nikhilrenny/555-pwm-bandpass-signal-generator/images/hardware/scope_full_chain/scope_05.jpg

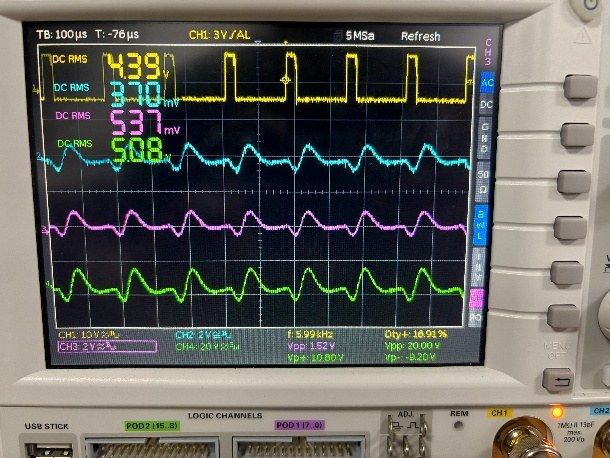
images/hardware/scope_full_chain/scope_05.jpg
