nikhilrenny/555-pwm-bandpass-signal-generator/images/hardware/scope_pwm_filter/scope_05.jpg

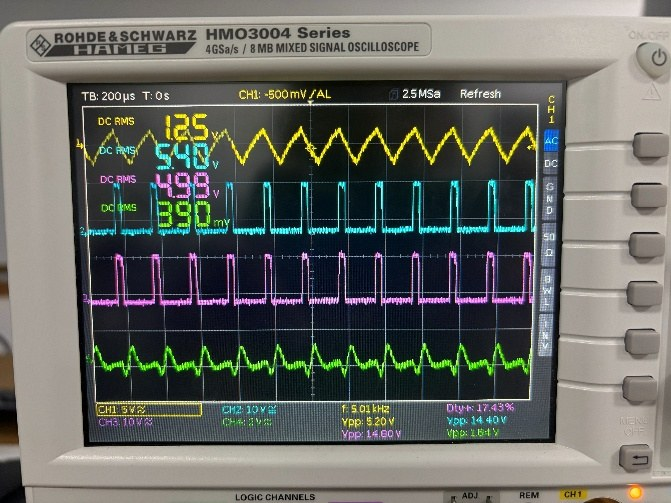
images/hardware/scope_pwm_filter/scope_05.jpg
