nikhilrenny/555-pwm-bandpass-signal-generator/images/hardware/scope_pwm_filter/scope_13.jpg

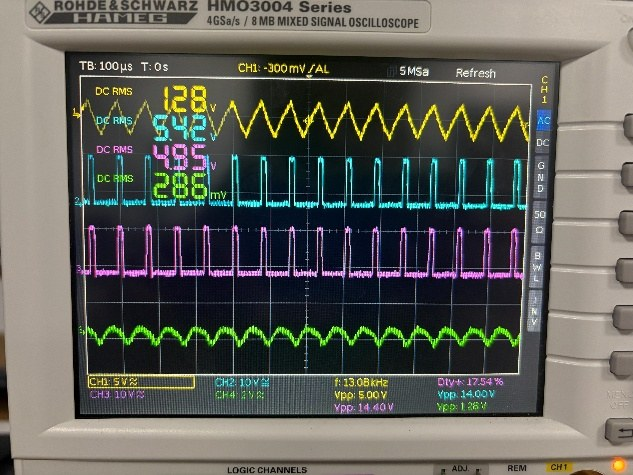
images/hardware/scope_pwm_filter/scope_13.jpg
