nikhilrenny/555-pwm-bandpass-signal-generator/images/schematics/block_diagram.jpg

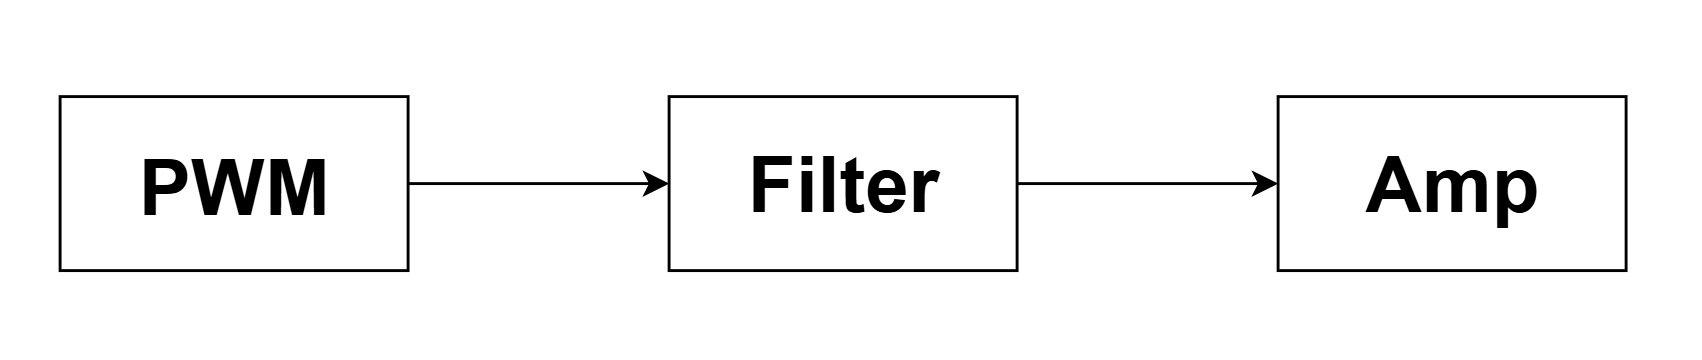
images/schematics/block_diagram.jpg
