nikhilrenny/555-pwm-bandpass-signal-generator/images/schematics/mfb_bandpass_filter.jpg

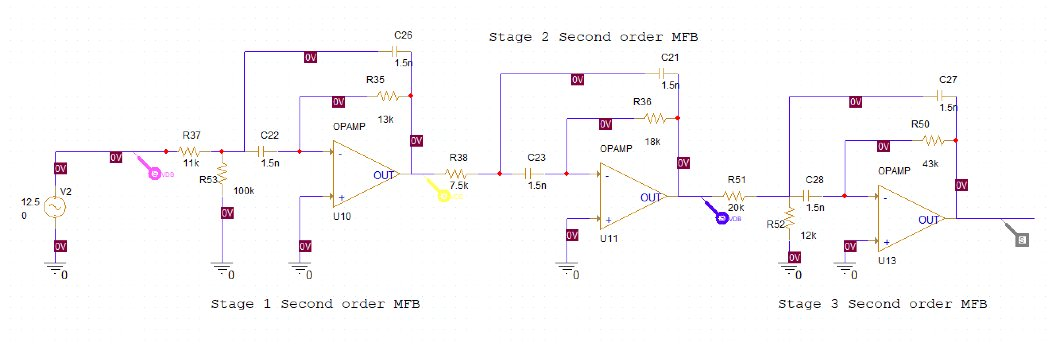
images/schematics/mfb_bandpass_filter.jpg
