nikhilrenny/555-pwm-bandpass-signal-generator/images/schematics/output_amplifier.jpg

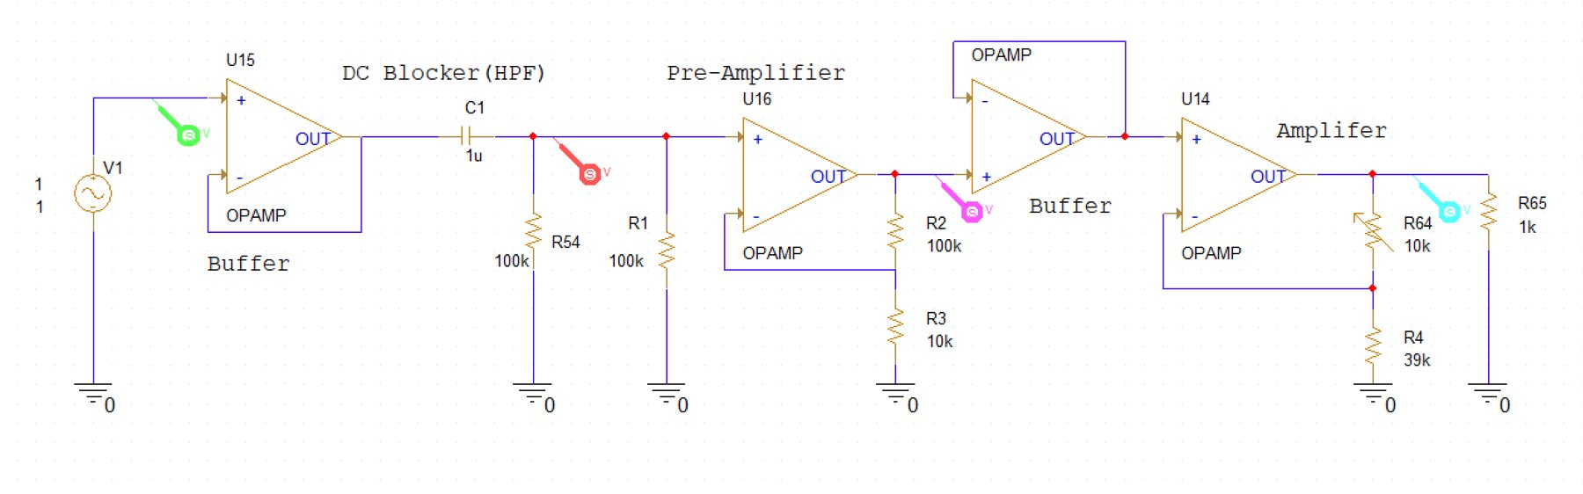
images/schematics/output_amplifier.jpg
