nikhilrenny/555-pwm-bandpass-signal-generator/images/schematics/pwm_generator.jpg

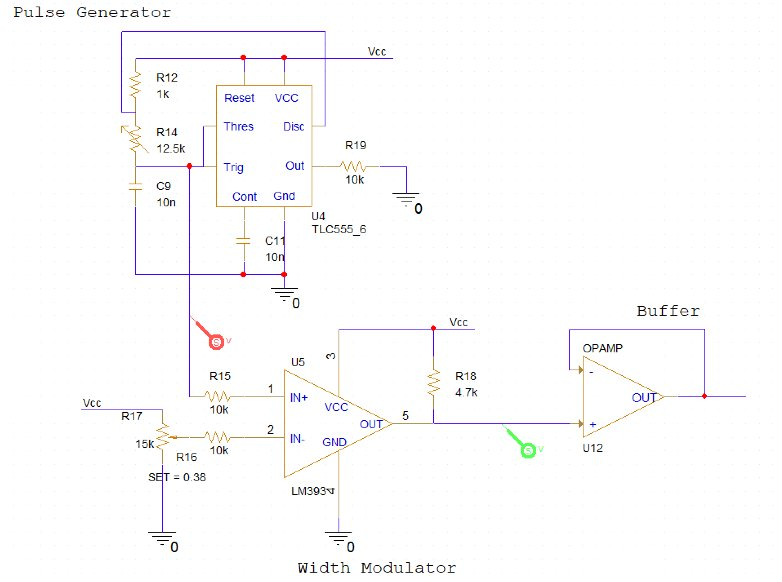
images/schematics/pwm_generator.jpg
