nikhilrenny/555-pwm-bandpass-signal-generator/images/simulation/filter/db_plot_ac.jpg

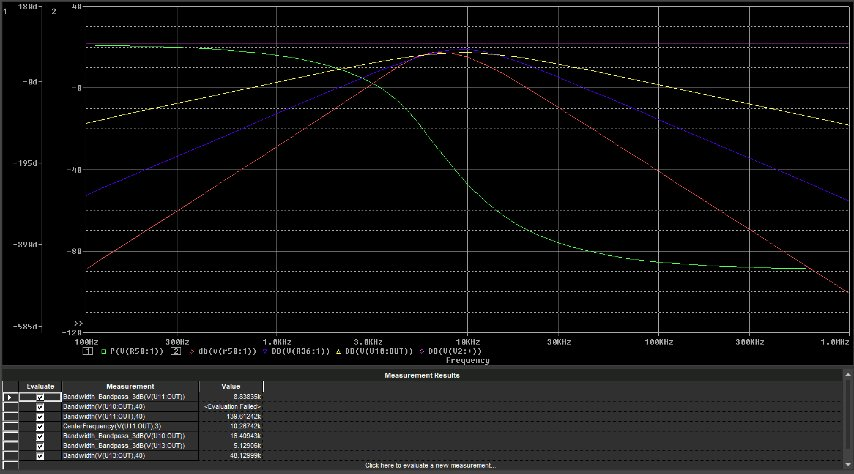
images/simulation/filter/db_plot_ac.jpg
