nikhilrenny/555-pwm-bandpass-signal-generator/images/simulation/filter/voltage_vs_freq_ac.jpg

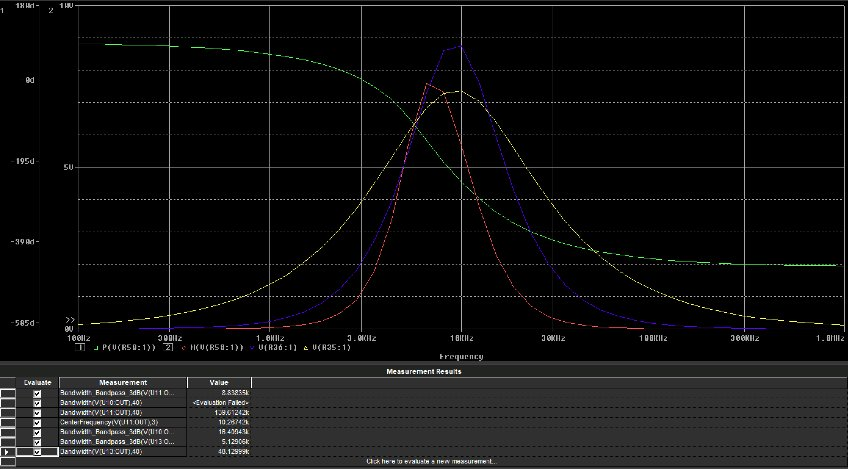
images/simulation/filter/voltage_vs_freq_ac.jpg
