nikhilrenny/555-pwm-bandpass-signal-generator/images/simulation/filter/voltage_vs_freq_ac_2.jpg

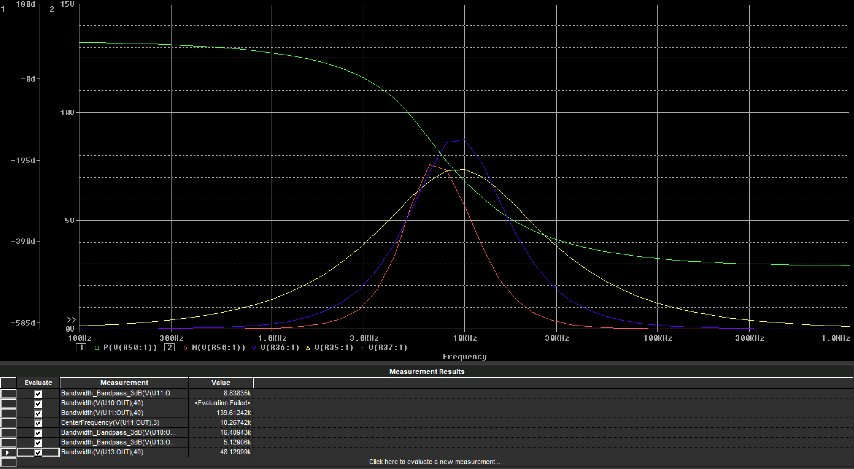
images/simulation/filter/voltage_vs_freq_ac_2.jpg
