nikhilrenny/555-pwm-bandpass-signal-generator/images/simulation/output/dc_block_hpf_1.jpg

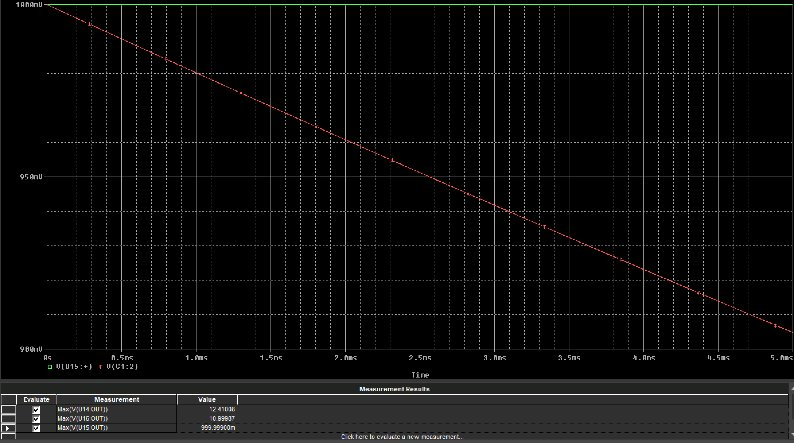
images/simulation/output/dc_block_hpf_1.jpg
