nikhilrenny/555-pwm-bandpass-signal-generator/images/simulation/output/dc_block_hpf_2.jpg

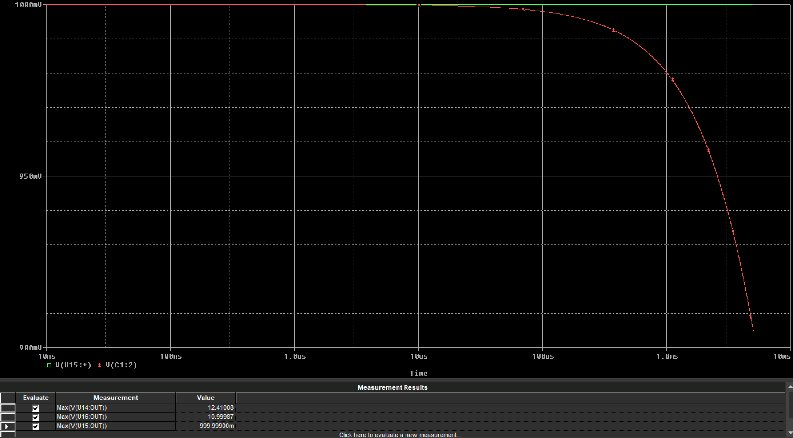
images/simulation/output/dc_block_hpf_2.jpg
