nikhilrenny/555-pwm-bandpass-signal-generator/images/simulation/pwm/cycle.jpg

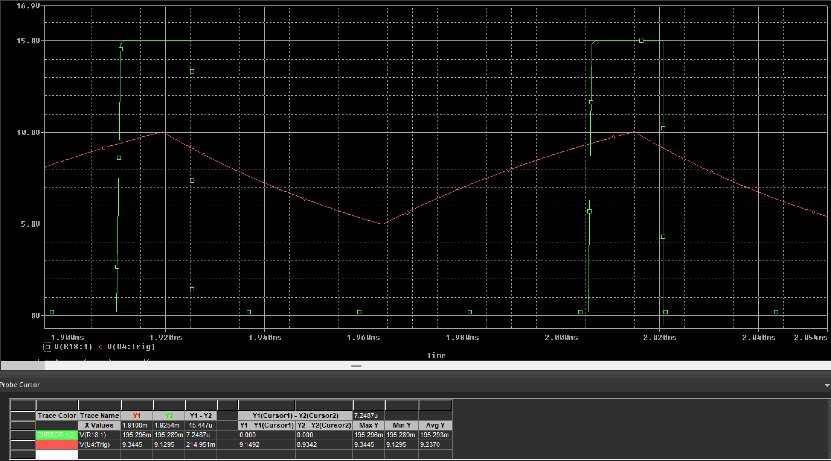
images/simulation/pwm/cycle.jpg
