nikhilrenny/555-pwm-bandpass-signal-generator/images/simulation/pwm/pulsewidth.jpg

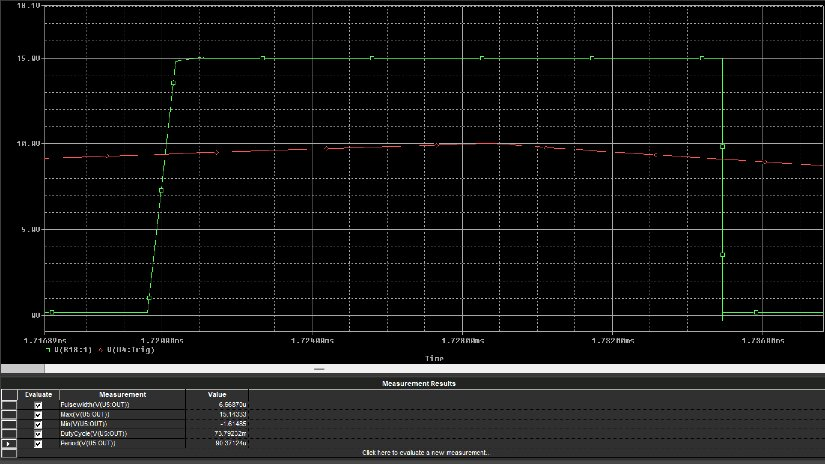
images/simulation/pwm/pulsewidth.jpg
