nikhilrenny/555-pwm-bandpass-signal-generator/images/simulation/pwm/slewrate.jpg

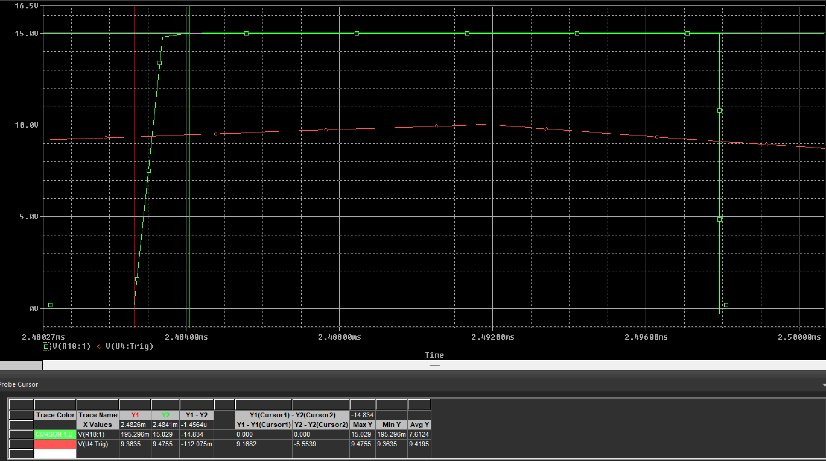
images/simulation/pwm/slewrate.jpg
