nikhilrenny/555-pwm-bandpass-signal-generator/images/simulation/pwm/startup.jpg

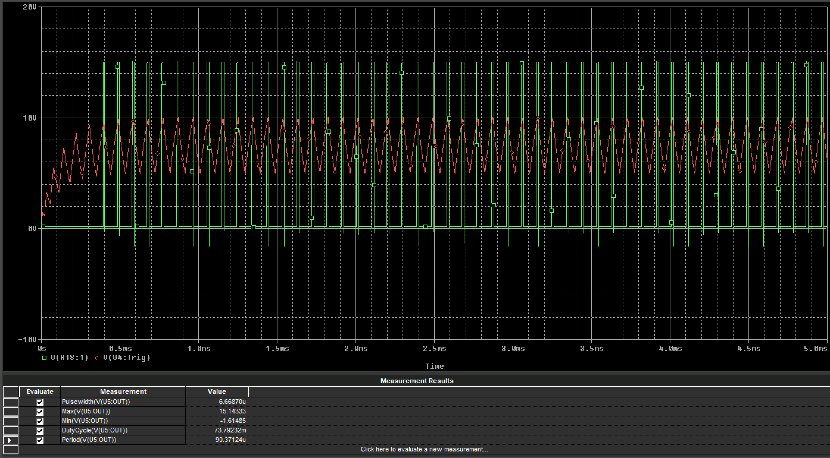
images/simulation/pwm/startup.jpg
