nikhilrenny/555-pwm-bandpass-signal-generator/images/simulation/pwm/ton.jpg

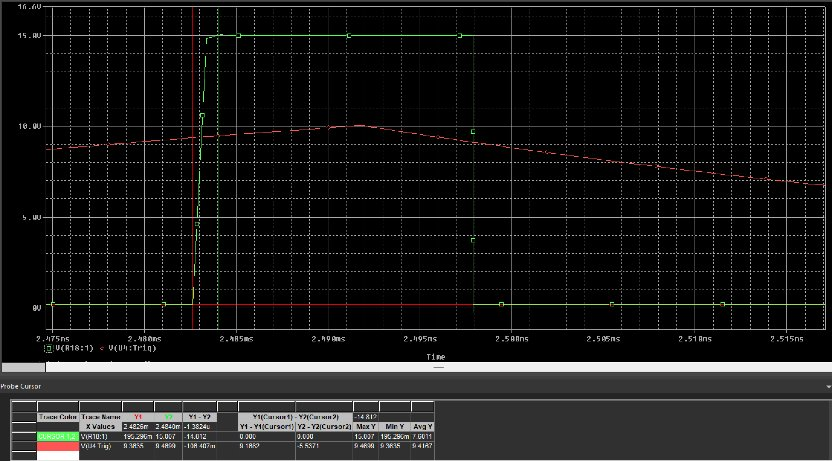
images/simulation/pwm/ton.jpg
