nikhilrenny/555-pwm-bandpass-signal-generator/images/hardware/setup/connections.jpg

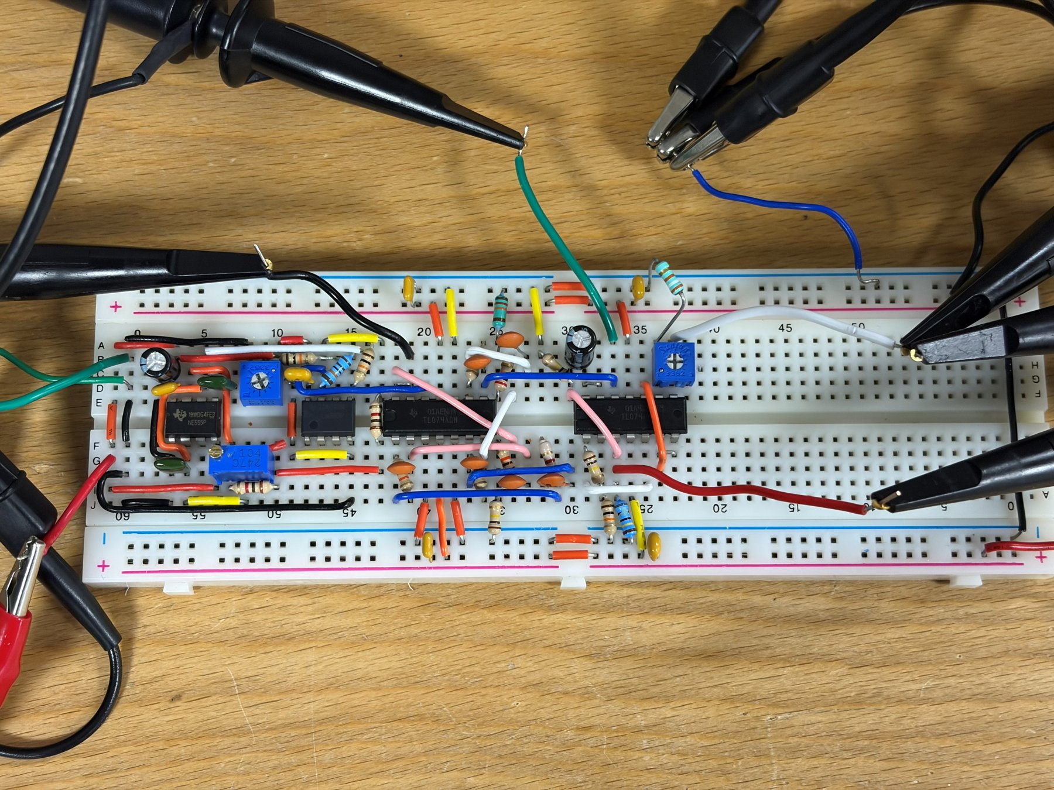
images/hardware/setup/connections.jpg
