nikhilrenny/555-pwm-bandpass-signal-generator/data/555_duty_cycle_test.csv

r2_ohm | frequency_khz | duty_pct
10 | 101.6 | 90.2
10000 | 7.1 | 51.0
75330 | 1.009 | 49.5
