nikhilrenny/555-pwm-bandpass-signal-generator/data/555_frequency_test.csv

r2_ohm | observed_khz | expected_khz | error_pct
10 | 100.0 | 141.0 | -29.1
100 | 92.12 | 120.0 | -23.2
220 | 81.0 | 100.0 | -19.0
10000 | 7.2 | 6.85 | 5.1
20000 | 3.7 | 3.5 | 5.7
30000 | 2.49 | 2.3 | 8.3
43000 | 1.74 | 1.6 | 8.8
47000 | 1.5 | 1.5 | 0.0
68000 | 1.12 | 1.05 | 6.7
75000 | 1.012 | 0.95 | 6.5
82000 | 0.9 | 0.87 | 3.4
