nikhilrenny/555-pwm-bandpass-signal-generator/images/hardware/setup/555_freq_test_1.jpg

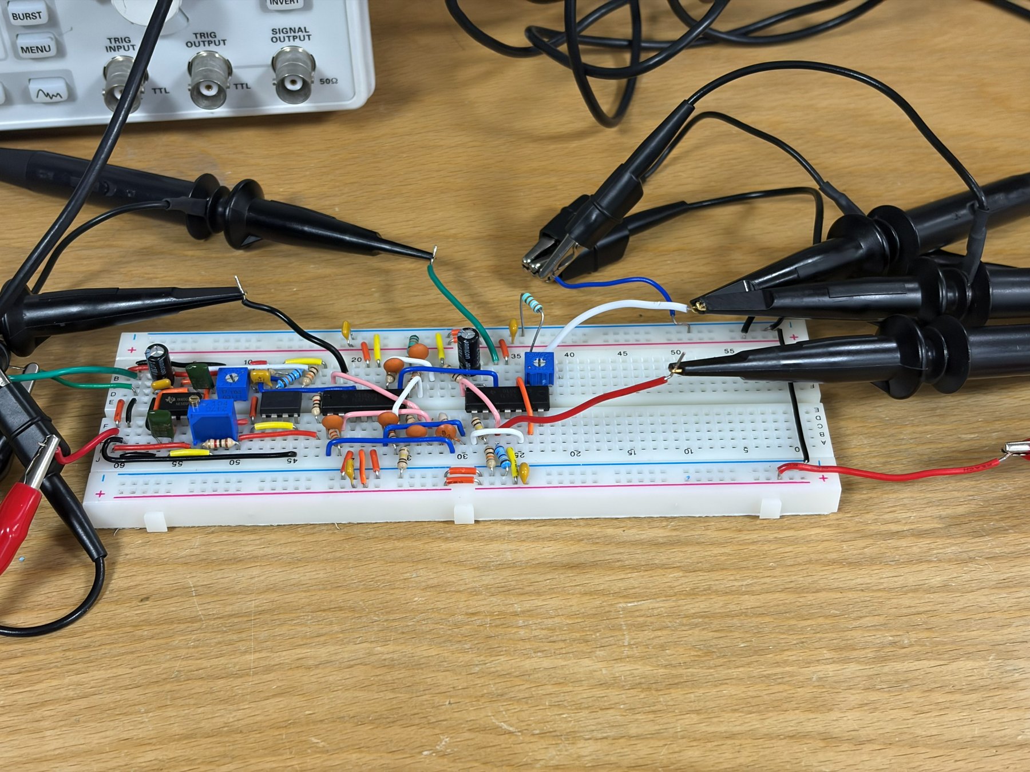
images/hardware/setup/555_freq_test_1.jpg
