nikhilrenny/555-pwm-bandpass-signal-generator/images/hardware/setup/555_freq_test_2.jpg

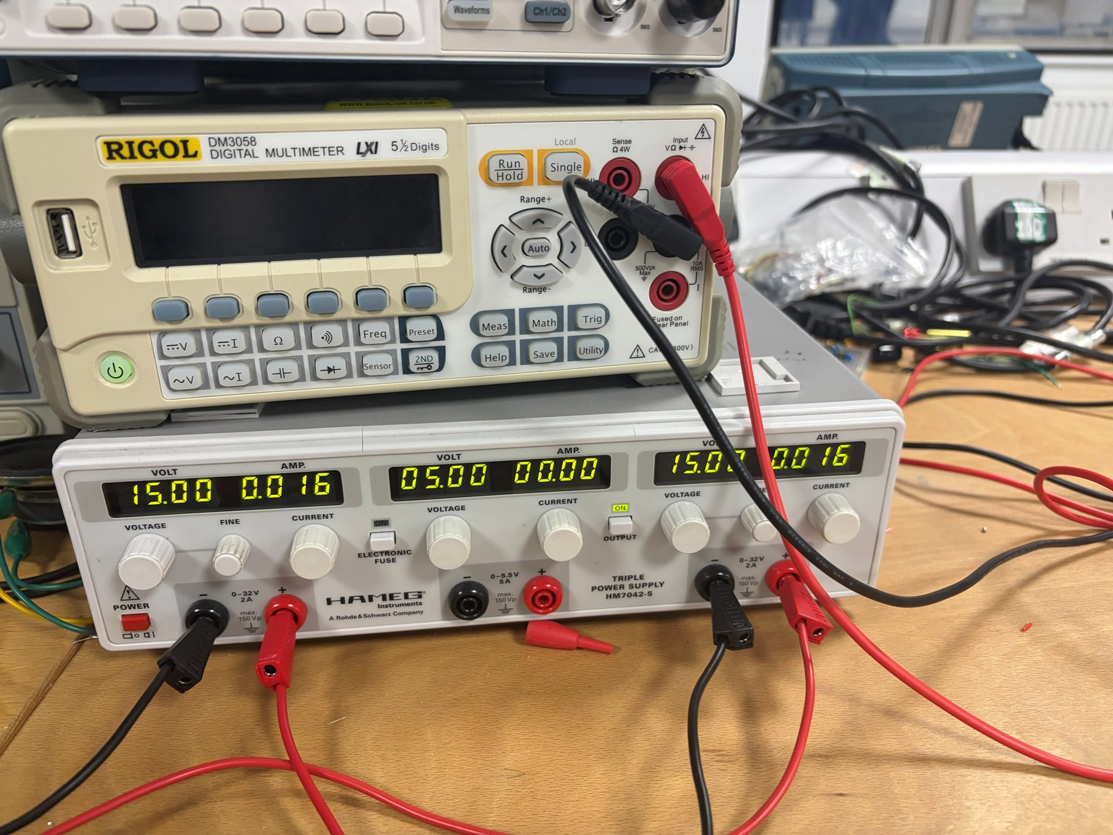
images/hardware/setup/555_freq_test_2.jpg
