nikhilrenny/555-pwm-bandpass-signal-generator/simulation/pspice/555-PSpiceFiles/SCHEMATIC1/555/555.cir

** Profile: "SCHEMATIC1-555"  [ d:\projects\555\555-PSpiceFiles\SCHEMATIC1\555.sim ] 

** Creating circuit file "555.cir" 
** WARNING: THIS AUTOMATICALLY GENERATED FILE MAY BE OVERWRITTEN BY SUBSEQUENT SIMULATIONS

*Libraries: 
* Profile Libraries :
* Local Libraries :
* From [PSPICE NETLIST] section of C:\cds_spb_home\cdssetup\OrCAD_PSpiceTIPSpice_Install\23.1.0\PSpice.ini file:
.lib "nom_pspti.lib" 
.lib "nom.lib" 

*Analysis directives: 
.TRAN  0 5m 0 1u SKIPBP 
.OPTIONS ADVCONV
.OPTIONS FILEMODELSEARCH
.OPTIONS ABSTOL= 1.0n
.OPTIONS ITL1= 1000
.OPTIONS ITL2= 200
.OPTIONS ITL4= 100
.OPTIONS RELTOL= 0.01
.OPTIONS VNTOL= 1.0m
.OPTIONS PTRANABSTOL= 1e-5
.OPTIONS PTRANVNTOL= 1e-4
.PROBE64 V(alias(*)) I(alias(*)) W(alias(*)) D(alias(*)) NOISE(alias(*)) 
.INC "..\SCHEMATIC1.net" 


.END
