nikhilrenny/555-pwm-bandpass-signal-generator/simulation/pspice/555-PSpiceFiles/SCHEMATIC1/sim/sim.cir

** Profile: "SCHEMATIC1-sim"  [ d:\projects\555\555-pspicefiles\schematic1\sim.sim ] 

** Creating circuit file "sim.cir" 
** WARNING: THIS AUTOMATICALLY GENERATED FILE MAY BE OVERWRITTEN BY SUBSEQUENT SIMULATIONS

*Libraries: 
* Profile Libraries :
* Local Libraries :
* From [PSPICE NETLIST] section of C:\cds_spb_home\cdssetup\OrCAD_PSpiceTIPSpice_Install\23.1.0\PSpice.ini file:
.lib "nom_pspti.lib" 
.lib "nom.lib" 

*Analysis directives: 
.AC DEC 10 100 100k
.OP
.OPTIONS ADVCONV
.OPTIONS FILEMODELSEARCH
.OPTIONS PTRANABSTOL= 1e-5
.OPTIONS PTRANVNTOL= 1e-4
.PROBE64 V(alias(*)) I(alias(*)) W(alias(*)) D(alias(*)) NOISE(alias(*)) 
.INC "..\SCHEMATIC1.net" 


.END
