nikhilrenny/555-pwm-bandpass-signal-generator/(list of files, drawings)

Other design files:
simulation/pspice/555.dsn
simulation/pspice/555.opj
