nikhilrenny/555-pwm-bandpass-signal-generator/(commit log)

2026-10-15 Add 555 PWM signal generator project
    [555_duty_cycle_test.csv, 555_frequency_test.csv, full_chain_sweep.csv, pwm_filter_sweep.csv]
2026-10-15 Update project title for PWM signal generator
2026-10-15 Add PSpice simulation files
    [555.dsn, 555.opj]
